neuweiler/ApiSauna/docs/schematics.pdf

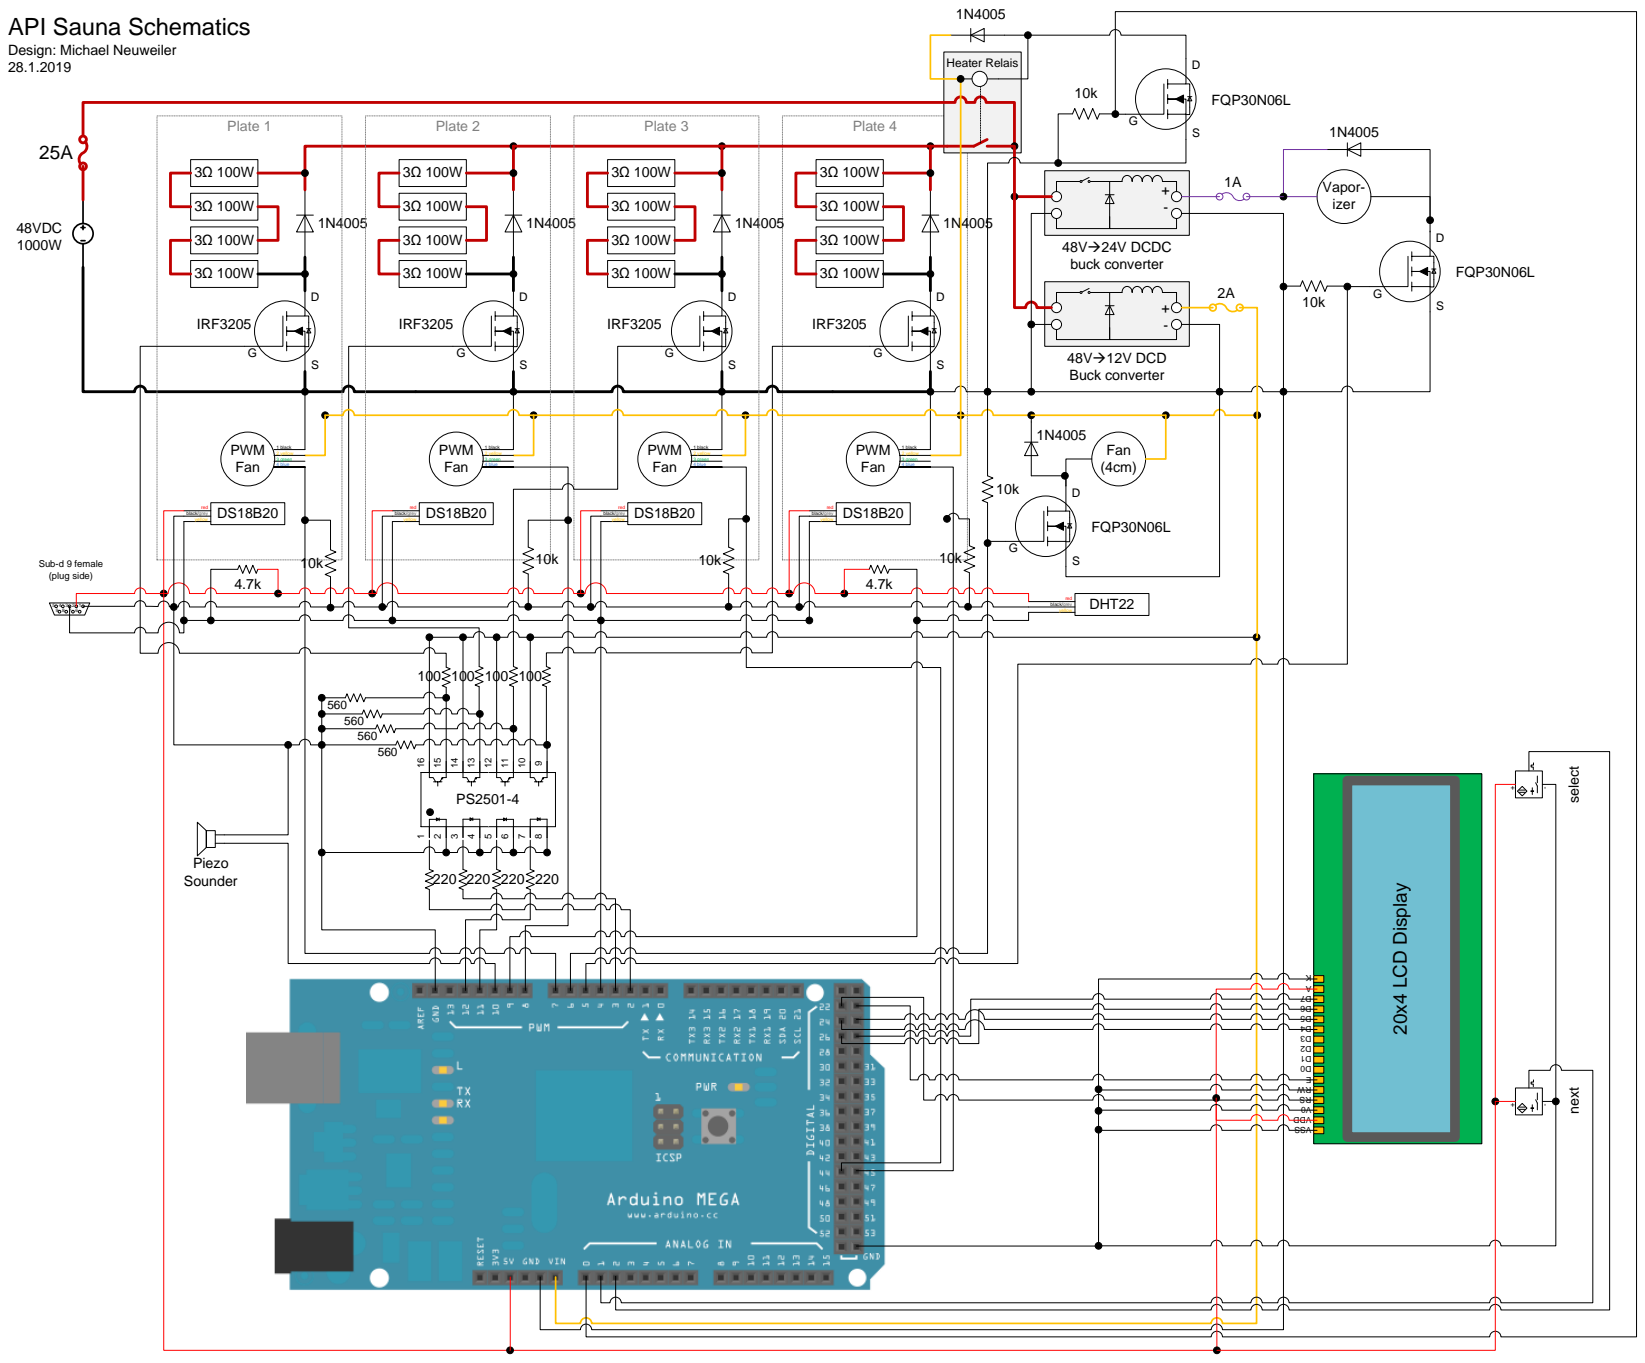
[picture p1: page 1]
Plate 4; Heater Relais; IRF3205; 1N4005 48VDC 1000W; 48Và24V DCDC buck converter; FQP30N06L D G; Plate 1; PWM Fan; 1 black 2 yellow 3 green 4 blue red black/grey yellow; Plate 2; Plate 3; Fan (4cm); Vapor- izer; DHT22 red black/grey yellow 4.7k; Piezo Sounder; - next select; 10k Sub-d 9 female (plug side) 5 4 3 2 1 9 8 7 6

API Sauna Schematics Design: Michael Neuweiler 28.1.2019

48Và12V DCD Buck converter

Display SSV DDV
