neuweiler/ApiSauna/ApiSauna.ino

/*
 * ApiSauna.ino
 *
 * The main application, hands over control to the Controller class.
 *
 Copyright (c) 2017 Michael Neuweiler

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
 */

#include "ApiSauna.h"

/**
 * The initial setup function called after device reset/power-up
 */
void setup()
{
    Serial.begin(CFG_SERIAL_SPEED);
    Serial.println(CFG_VERSION);

    Controller::getInstance()->initialize();
}

/**
 * The main program loop
 */
void loop()
{
    Controller::getInstance()->process();

    delay(CFG_LOOP_DELAY);
}
