neuweiler/ApiSauna/Controller.cpp

/*
 * Controller.cpp
 *
 * The main controller which coordinates and controlls all parts of the
 * bee sauna..
 *
 Copyright (c) 2017 Michael Neuweiler

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
 */

#include "Controller.h"

Controller::Controller()
{
    actualTemperature = -999;
    targetTemperature = 0;
    plateTemperature = 0;
    plateTargetTemperature = 0;

    tickCounter = 0;
    pid = NULL;
}

Controller::~Controller()
{
    if (pid) {
        delete pid;
        pid = NULL;
    }
}

/**
 * Return the instance of the singleton
 */
Controller *Controller::getInstance()
{
    static Controller instance;
    return &instance;
}

/**
 * Initialize the controller and referenced devices.
 */
void Controller::initialize()
{
    Logger::info(F("initializing controller"));

    if (!Configuration::getInstance()->load() || !Statistics::getInstance()->load()) {
        status.setSystemState(Status::error);
        return;
    }
    Logger::setLoglevel((Logger::LogLevel)Configuration::getInstance()->getParams()->loglevel);

    initOutput();
    powerDownDevices();

    ProgramHandler::getInstance()->initPrograms();
    ProgramHandler::getInstance()->attach(this);
    hid.initialize();
    humidifier.initialize();

    SimpleList<SensorAddress> addressList = detectTemperatureSensors();
    if (!assignPlateSensors(addressList) || !assignHiveSensors(addressList)) {
        for (SimpleList<SensorAddress>::iterator itr = addressList.begin(); itr != addressList.end(); ++itr) {
            Logger::info(F("  found sensor: %#08lx%08lx"), itr->high, itr->low);
        }
        status.setSystemState(Status::error);
        return;
    }

    initPid();
    status.setSystemState(Status::ready);
    serialConsole.printMenu();
}

/**
 * Initialize output ports
 */
void Controller::initOutput()
{
    Logger::info(F("initializing output"));

    ConfigurationIO *configIo = Configuration::getIO();
    pinMode(configIo->heaterRelay, OUTPUT);
    for (int i = 0; i < Configuration::getParams()->numberOfPlates; i++) {
        if (configIo->heater[i] != 0)
            pinMode(configIo->heater[i], OUTPUT);
        if (configIo->fan[i] != 0)
            pinMode(configIo->fan[i], OUTPUT);
    }
    pinMode(configIo->vaporizer, OUTPUT);
    pinMode(configIo->humidifierFan, OUTPUT);
}

/**
 * Initialize the PID to define the plateTemperature based on the targetTemperature and the
 * actual temperature of the hive.
 */
void Controller::initPid()
{
    pid = new PID(&actualTemperature, &plateTemperature, &targetTemperature, 0, 0, 0, DIRECT);
    pid->SetOutputLimits(0, Configuration::getParams()->plateOverTemp);
    pid->SetSampleTime(CFG_LOOP_DELAY);
    pid->SetMode(AUTOMATIC);
}

/**
 * Tell all devices to power-down.
 */
void Controller::powerDownDevices()
{
    for (SimpleList<Plate>::iterator itr = plates.begin(); itr != plates.end(); ++itr) {
        itr->setMaximumPower(0);
        itr->setFanSpeed(Configuration::getParams()->minFanSpeed);
        itr->process();
        itr->pause();
    }
    humidifier.setMinHumidity(0);
    humidifier.setMaxHumidity(1);
    humidifier.setFanSpeed(0);
    humidifier.process();

    delay(500);
    digitalWrite(Configuration::getIO()->heaterRelay, LOW);
}

/**
 *  Find all temperature sensor addresses (DS18B20).
 */
SimpleList<SensorAddress> Controller::detectTemperatureSensors()
{
    SimpleList<SensorAddress> addressList;
    Logger::info(F("detecting temperature sensors"));
    TemperatureSensor::resetSearch();

    while (true) {
        SensorAddress address = TemperatureSensor::search();
        if (address.value == 0)
            break;
        Logger::info(F("  found sensor: %#08lx%08lx"), address.high, address.low);
        addressList.push_back(address);
    }
    TemperatureSensor::prepareData(); // kick the sensors to prepare data
    return addressList;
}

bool Controller::containsSensorAddress(SimpleList<SensorAddress> &addressList, SensorAddress address)
{
    for (SimpleList<SensorAddress>::iterator itrAddress = addressList.begin(); itrAddress != addressList.end(); ++itrAddress) {
        if (itrAddress->value == address.value)
            return true;
    }
    return false;
}

/**
 * Assign all found temperature sensors either to heating plates or use them to measure the
 * hive's temperature.
 */
bool Controller::assignPlateSensors(SimpleList<SensorAddress> &addressList)
{
    ConfigurationIO *configIO = Configuration::getIO();
    ConfigurationSensor *configSensor = Configuration::getSensor();

    plates.reserve(Configuration::getParams()->numberOfPlates);
    for (int i = 0; i < Configuration::getParams()->numberOfPlates; i++) {
        if (configSensor->addressPlate[i].value != 0 && containsSensorAddress(addressList, configSensor->addressPlate[i]) && configIO->fan[i] != 0
                && configIO->heater[i] != 0) {
            Logger::info(F("attaching sensor %#08lx%08lx, heater pin %d, fan pin %d to plate #%d"), configSensor->addressPlate[i].high,
                    configSensor->addressPlate[i].low, configIO->heater[i], configIO->fan[i], i + 1);
            Plate plate = Plate();
            plates.push_back(plate);
        }
    }

    // initialize plates after adding them to list because adding deletes/re-creates the plate objects and would mess with its allocated objects otherwise
    int i = 0;
    for (SimpleList<Plate>::iterator itr = plates.begin(); itr != plates.end(); ++itr) {
        itr->initialize(i++);
    }

    if (Configuration::getParams()->numberOfPlates != plates.size()) {
        Logger::error(F("unable to locate all configured plate sensors (%d of %d) !!"), plates.size(), Configuration::getParams()->numberOfPlates);
        status.errorCode = Status::plateSensorsNotFound;
        return false;
    }
    return true;
}

/**
 * Verify that all configured hive temperature sensors are found in the search for sensors.
 */
bool Controller::assignHiveSensors(SimpleList<SensorAddress> &addressList)
{
    ConfigurationSensor *configSensor = Configuration::getSensor();

    for (int i = 0; configSensor->addressHive[i].value != 0 && i < CFG_MAX_NUMBER_PLATES; i++) {
        if (containsSensorAddress(addressList, configSensor->addressHive[i])) {
            Logger::info(F("attaching sensor %#08lx%08lx as hive sensor #%d"), configSensor->addressHive[i].high, configSensor->addressHive[i].low,
                    i + 1);
            TemperatureSensor sensor = TemperatureSensor(i, false);
            hiveTempSensors.push_back(sensor);
        } else {
            Logger::error(F("unable to locate all configured hive sensors (%#l08x%08lx missing) !!"), configSensor->addressHive[i].high,
                    configSensor->addressHive[i].low);
            status.errorCode = Status::hiveSensorsNotFound;
            return false;
        }
    }
    return true;
}

/**
 * Retrieve temperature data from all sensors and return second highest value (in 0.1 deg C)
 *
 * We assume that either 1 ore 3+ sensors are being used and use a bit a more aggressive
 * approach to heat the hive - if one temp sensor is placed badly or being heated by the bees,
 * it would take too long to heat up the entire hive.
 */
int16_t Controller::retrieveHiveTemperatures()
{
    int16_t max = -999, secondMax = -999;

    int i = 0;
    for (SimpleList<TemperatureSensor>::iterator itr = hiveTempSensors.begin(); itr != hiveTempSensors.end(); ++itr) {
        itr->retrieveData();
        if (i < CFG_MAX_NUMBER_PLATES)
            status.temperatureHive[i++] = itr->getTemperatureCelsius();
        max = max(max, itr->getTemperatureCelsius());
    }

    for (i = 0; i < CFG_MAX_NUMBER_PLATES; i++) {
        if (status.temperatureHive[i] != max) {
            secondMax = max(secondMax, status.temperatureHive[i]);
        }
    }
    if (secondMax == -999) {
        secondMax = max;
    }
    status.temperatureActualHive = secondMax;
    return secondMax;
}

/**
 * Calculate the desired plate temperature based on the hive temperature and the current state. (in 0.1 deg C)
 */
int16_t Controller::calculatePlateTargetTemperature()
{
    Program *runningProgram = ProgramHandler::getInstance()->getRunningProgram();
    if (actualTemperature == -999 || runningProgram == NULL) {
        return 0;
    }

    if (status.getSystemState() == Status::preHeat) {
        targetTemperature = runningProgram->temperaturePreHeat;
    } else {
        targetTemperature = runningProgram->temperatureHive;
    }

    pid->Compute();

    // don't set directly as plateTemperature tends to jump. Dampen with 0.1 deg per second
    if (plateTemperature > plateTargetTemperature)
        plateTargetTemperature++;
    else if (plateTemperature < plateTargetTemperature)
        plateTargetTemperature--;

    plateTargetTemperature = constrain(plateTargetTemperature, 0, runningProgram->temperaturePlate);
    status.temperatureTargetHive = targetTemperature;
    status.temperatureTargetPlate = plateTargetTemperature;

    return plateTargetTemperature;
}

/**
 * Check if a state has reached its execution time or a problem has occured
 */
void Controller::updateProgramState()
{
    ProgramHandler *programHandler = ProgramHandler::getInstance();
    Program *runningProgram = programHandler->getRunningProgram();
    uint32_t timeRemaining = programHandler->calculateTimeRemaining();

    if (actualTemperature > Configuration::getParams()->hiveOverTemp) {
        Logger::error(F("ALERT - OVER-TEMPERATURE IN HIVE ! Trying to recover, please open the cover to help cool down the hive!"));
        status.setSystemState(Status::overtemp);
        status.errorCode = Status::overtempHive;
    }
    if (status.getSystemState() == Status::overtemp && actualTemperature < Configuration::getParams()->hiveOverTempRecover) {
        Logger::info(F("recovered from over-temperature, shutting down."));
        programHandler->stop();
    }

    if (status.getSystemState() == Status::running && timeRemaining < 2) {
        Logger::info(F("program finished."));
        programHandler->stop();
    }

    if (status.getSystemState() == Status::preHeat && runningProgram
            && (timeRemaining == 0 || (actualTemperature >= runningProgram->temperaturePreHeat &&
                    timeRemaining < programHandler->calculateTimeRunning()))) {
        programHandler->switchToRunning();
    }
}

void Controller::handleEvent(ProgramEvent event, Program *program)
{
    Logger::debug(F("controller: incoming event %d, program: %s"), event, (program ? program->name : "n/a"));

    switch (event) {
    case startProgram:
    case updateProgram:
        handleProgramChange(program);
        break;
    case stopProgram:
        powerDownDevices();
        break;
    case pauseProgram:
        for (SimpleList<Plate>::iterator itr = plates.begin(); itr != plates.end(); ++itr) {
            itr->pause();
        }
        break;
    case resumeProgram:
        for (SimpleList<Plate>::iterator itr = plates.begin(); itr != plates.end(); ++itr) {
            itr->resume();
        }
        break;
    }
}

/**
 * This is the main control loop.
 */
void Controller::process()
{
    hid.process();
    serialConsole.process();

    if (tickCounter++ > 9) {
        tickCounter = 0;
        humidifier.process();
        actualTemperature = retrieveHiveTemperatures();
        updateProgramState();

        switch (status.getSystemState()) {
        case Status::init:
            break;
        case Status::ready:
            break;
        case Status::preHeat:
        case Status::running: {
            int16_t plateTemp = calculatePlateTargetTemperature();
int i = 0;
            for (SimpleList<Plate>::iterator itr = plates.begin(); itr != plates.end(); ++itr) {
if (i == 2 || i == 3) {
	if (status.temperatureHive[2] <390 && status.temperatureHive[3] < 390)
		plateTemp = 750;
	else if (status.temperatureHive[2] <400 && status.temperatureHive[3] < 400)
		plateTemp = 700;
	else if (status.temperatureHive[2] <410 && status.temperatureHive[3] < 410)
		plateTemp = 650;
}
i++;
                itr->setTargetTemperature(plateTemp);
                itr->process();
            }
            Program *runningProgram = ProgramHandler::getInstance()->getRunningProgram();
            if (runningProgram->changed) {
                handleProgramChange(runningProgram);
                runningProgram->changed = false;
            }
            break;
        }
        case Status::overtemp: // shut-down heaters, plate fan to minimum, full blow humidifier fan (fresh air) !!
            for (SimpleList<Plate>::iterator itr = plates.begin(); itr != plates.end(); ++itr) {
                itr->setMaximumPower(0);
                itr->setFanSpeed(Configuration::getParams()->minFanSpeed);
                itr->process();
            }
            humidifier.setMinHumidity(99);
            humidifier.setMaxHumidity(100);
            humidifier.setFanSpeed(255);
            humidifier.process();
            delay(200); // wait a bit before trying to open the relay
            digitalWrite(Configuration::getIO()->heaterRelay, LOW);
            break;
        case Status::shutdown:
            break;
        case Status::error:
            powerDownDevices();
            break;
        }
        TemperatureSensor::prepareData();
    }
}

void Controller::handleProgramChange(Program *program)
{
    Status::SystemState state = status.getSystemState();
    bool preHeat = (state == Status::preHeat);
    bool running = (state == Status::running);

    Logger::info(F("Updating devices with new program settings"));

    // adjust the PID which defines the target temperature of the plates based on the hive temp
    pid->SetOutputLimits((preHeat ? program->temperaturePreHeat : program->temperatureHive), program->temperaturePlate);
    pid->SetTunings(program->hiveKp, program->hiveKi, program->hiveKd);
    plateTargetTemperature = program->temperaturePlate;

    // adjust the parameters of the plates
    for (SimpleList<Plate>::iterator itr = plates.begin(); itr != plates.end(); ++itr) {
        itr->setPIDTuning(program->plateKp, program->plateKi, program->plateKd);
        itr->setMaximumPower(Configuration::getParams()->maxHeaterPower);
        itr->setFanSpeed(preHeat ? program->fanSpeedPreHeat : program->fanSpeed);
    }

    // adjust the parameters of the humidifier
    humidifier.setFanSpeed(program->fanSpeedHumidifier);
    humidifier.setMinHumidity(program->humidityMinimum);
    humidifier.setMaxHumidity(program->humidityMaximum);

    digitalWrite(Configuration::getIO()->heaterRelay, (running || preHeat ? HIGH : LOW));
    delay(200); // allow the relay to open/close
}

int16_t Controller::getHiveTargetTemperature()
{
    return targetTemperature;
}
