neuweiler/ApiSauna/Configuration.cpp

/*
 * Configuration.cpp
 *
 Copyright (c) 2017 Michael Neuweiler

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
 */

#include "Configuration.h"

Configuration::Configuration()
{
}

Configuration::~Configuration()
{
}

/**
 * Return the instance of the singleton
 */
Configuration *Configuration::getInstance()
{
    static Configuration instance;
    return &instance;
}

/**
 * Load the configuration from EEPROM and verify the CRC values
 * as well as the existance of the ApiSauna token.
 *
 * If the token is not found, it is assumed that the configuration was never saved on this board and the config is re-set and saved.
 * If a CRC check fails, a error is printed to the log and HID and false is returned - causing the controller to go into error state.
 */
bool Configuration::load()
{
    Logger::info(F("loading configuration"));
    EEPROM.get(CONFIG_ADDRESS_IO, *getIO());
    EEPROM.get(CONFIG_ADDRESS_PARAMS, *getParams());
    EEPROM.get(CONFIG_ADDRESS_SENSOR, *getSensor());

    if (getParams()->token != CFG_EEPROM_CONFIG_TOKEN) {
        Logger::warn(F("no ApiSauna token found in EEPROM --> resetting configuration and statistics"));
        reset();
        save();
        Statistics::getInstance()->reset();
        Statistics::getInstance()->save();
    }

    if (getParams()->crc != Crc::calculate((uint8_t *) getParams() + 4, sizeof(ConfigurationParams) - 4)) {
        Logger::error(F("invalid crc detected in parameter configuration"));
        status.errorCode = Status::crcParam;
        return false;
    }
    if (getIO()->crc != Crc::calculate((uint8_t *) getIO() + 4, sizeof(ConfigurationIO) - 4)) {
        Logger::error(F("invalid crc detected in I/O configuration"));
        status.errorCode = Status::crcIo;
        return false;
    }
    if (getSensor()->crc != Crc::calculate((uint8_t *) getSensor() + 4, sizeof(ConfigurationSensor) - 4)) {
        Logger::error(F("invalid crc detected in sensor configuration"));
        status.errorCode = Status::crcSensor;
        return false;
    }

    if (getParams()->numberOfPlates > CFG_MAX_NUMBER_PLATES) {
        getParams()->numberOfPlates = CFG_MAX_NUMBER_PLATES;
    }

    return true;
}

/**
 * Calculate and set the CRC values of all configurations.
 */
void Configuration::updateCrc()
{
    getParams()->crc = Crc::calculate((uint8_t*) (getParams()) + 4, sizeof(ConfigurationParams) - 4);
    getIO()->crc = Crc::calculate((uint8_t*) (getIO()) + 4, sizeof(ConfigurationIO) - 4);
    getSensor()->crc = Crc::calculate((uint8_t*) (getSensor()) + 4, sizeof(ConfigurationSensor) - 4);
}

/**
 * Re-calc the CRC values and store all configuration blocks to EEPROM.
 */
void Configuration::save()
{
    Logger::info(F("saving configuration to EEPROM"));

    updateCrc();
    EEPROM.put(CONFIG_ADDRESS_IO, *getIO());
    EEPROM.put(CONFIG_ADDRESS_PARAMS, *getParams());
    EEPROM.put(CONFIG_ADDRESS_SENSOR, *getSensor());

    Logger::info(F("done"));
}

/**
 * Reset the configuration to default values and update the CRCs.
 */
void Configuration::reset()
{
    Logger::info(F("resetting configuration to default values"));

    ConfigurationIO *configIO = getIO();
    ConfigurationParams *configParams = getParams();
    ConfigurationSensor *configSensor = getSensor();

    configParams->token = CFG_EEPROM_CONFIG_TOKEN;
    configParams->version = 1;

    for (int i = 0; i < CFG_MAX_NUMBER_PLATES; i++) {
        configIO->heater[i] = 0;
        configIO->fan[i] = 0;
        configSensor->addressPlate[i].value = 0;
        configSensor->addressHive[i].value = 0;
    }

    configIO->heartbeat = 13; //13 is L, 73 is TX, 72 is RX
    configIO->temperatureSensor = 4;
    configIO->humiditySensor = 9;
    configIO->humiditySensorType = 22;
    configIO->vaporizer = 5;
    configIO->humidifierFan = 6;
    configIO->heaterRelay = A0;
    configIO->heater[0] = 2;
    configIO->heater[1] = 3;
    configIO->heater[2] = 11;
    configIO->heater[3] = 12;
    configIO->fan[0] = 7;
    configIO->fan[1] = 8;
    configIO->fan[2] = 44;
    configIO->fan[3] = 45;
    configIO->buttonNext = A1;
    configIO->buttonSelect = A2;
    configIO->beeper = 10;
    configIO->lcdRs = 22;
    configIO->lcdEnable = 23;
    configIO->lcdD4 = 24;
    configIO->lcdD5 = 25;
    configIO->lcdD6 = 26;
    configIO->lcdD7 = 27;

    configParams->numberOfPlates = 4;
    configParams->maxHeaterPower = 170;
    configParams->minFanSpeed = 10;
    configParams->hiveOverTemp = 460;
    configParams->hiveOverTempRecover = 350;
    configParams->plateOverTemp = 850;
    configParams->usePWM = 0;
    configParams->maxConcurrentHeaters = 2;
    configParams->humidifierFanDryTime = 2;
    configParams->loglevel = Logger::Info;

    configSensor->addressPlate[0].value = 0x0;
    configSensor->addressPlate[1].value = 0x0;
    configSensor->addressPlate[2].value = 0x0;
    configSensor->addressPlate[3].value = 0x0;
    configSensor->addressHive[0].value = 0x0;
    configSensor->addressHive[1].value = 0x0;
    configSensor->addressHive[2].value = 0x0;
    configSensor->addressHive[3].value = 0x0;

    updateCrc();
}

/*
 * Returns the singleton instance of the I/O configuration.
 */
ConfigurationIO *Configuration::getIO()
{
    static ConfigurationIO configIO;
    return &configIO;
}

/*
 * Returns the singleton instance of the parameter configuration.
 */
ConfigurationParams *Configuration::getParams()
{
    static ConfigurationParams configParams;
    return &configParams;
}

/*
 * Returns the singleton instance of the sensor configuration.
 */
ConfigurationSensor *Configuration::getSensor()
{
    static ConfigurationSensor configSensor;
    return &configSensor;
}
