neuweiler/ApiSauna/Plate.cpp

/*
 * Plate.cpp
 *
 * Class which controls a single heating palte which consists of a heating element,
 * temperature sensor (to measure the plate's heat) and a fan to distribute the heat.
 *
 Copyright (c) 2017 Michael Neuweiler

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
 */

#include "Plate.h"

uint8_t Plate::activeHeaters = 0;

Plate::Plate() :
        Device()
{
    currentTemperature = 0.0;
    targetTemperature = 0.0;
    power = 0.0;
    maxPower = 0;
    index = 0;
    pid = NULL;
    sensorHeater = NULL;
    heater = NULL;
    fan = NULL;
    paused = false;
    on = false;
}

void Plate::initialize()
{
    Device::initialize();

    maxPower = Configuration::getParams()->maxHeaterPower;

    pid = new PID(&currentTemperature, &power, &targetTemperature, 0, 0, 0, DIRECT);
    pid->SetOutputLimits(0, maxPower);
    pid->SetSampleTime(CFG_LOOP_DELAY);
    pid->SetMode(AUTOMATIC);
}

void Plate::initialize(uint8_t index)
{
    Logger::debug(F("initializing plate %d"), index + 1);

    initialize();
    this->index = index;
    sensorHeater = new TemperatureSensor(index, true);
    heater = new Heater(index);
    fan = new Fan(Configuration::getIO()->fan[index]);
    fan->setSpeed(Configuration::getParams()->minFanSpeed);
}

Plate::~Plate()
{
}

/**
 * Set the desired temperature of the plate (in 0.1 deg C)
 */
void Plate::setTargetTemperature(int16_t temperature)
{
    targetTemperature = temperature;
}

int16_t Plate::getTargetTemperature()
{
    return targetTemperature;
}

/**
 * Set the maximum temperature of the plate (0-255)
 */
void Plate::setMaximumPower(uint8_t power)
{
    this->maxPower = constrain(power, (double ) 0, Configuration::getParams()->maxHeaterPower);
    pid->SetOutputLimits(0, this->maxPower);
}

uint8_t Plate::getMaximumPower()
{
    return maxPower;
}

/**
 * Set the plate's fan speed (0-255)
 */
void Plate::setFanSpeed(uint8_t speed)
{
    fan->setSpeed(speed);
    status.fanSpeedPlate[index] = speed;
}

/**
 * Set the tuning parameters of the PID controller for the plate temperature
 */
void Plate::setPIDTuning(double kp, double ki, double kd)
{
    pid->SetTunings(kp, ki, kd);
}

/**
 * Get the temperature of the plate in 0.1 deg C
 */
int16_t Plate::getTemperature()
{
    return sensorHeater->getTemperatureCelsius();
}

/**
 * Get the applied power of the heater (0-255)
 */
uint8_t Plate::getPower()
{
    return heater->getPower();
}

/**
 * Get the current fan speed.
 */
uint8_t Plate::getFanSpeed()
{
    return fan->getSpeed();
}

/**
 * Get the plate's index.
 */
uint8_t Plate::getIndex()
{
    return index;
}

/**
 * Interrupt the heating
 */
void Plate::pause()
{
    paused = true;
    heater->setPower(0);
}

/**
 * Resume normal operation
 */
void Plate::resume()
{
    paused = false;
}

/**
 * Update the plat's PID data and derive the power level to command (0-255 for PWM, 0 / 255 for non-PWM).
 * In non-PWM mode, the number of concurrently active plates is also limited to the configured amount.
 *
 */
uint8_t Plate::calculateHeaterPower()
{
    ConfigurationParams *params = Configuration::getParams();

    pid->Compute(); // updates power
    if (Logger::isDebug()) {
        Logger::debug(F("Calculated power for plate %d: %d"), index, power);
    }

    if (currentTemperature > params->plateOverTemp) {
        Logger::error(F("ALERT !!! Plate %d is over-heating !!!"), index + 1);
        status.setSystemState(Status::overtemp);
        status.errorCode = Status::overtempPlate;
        power = 0;
    }

    if (params->usePWM) {
        return constrain(power, (double )0, maxPower);
    } else {
        if ((power > params->maxHeaterPower / 2) && (activeHeaters < params->maxConcurrentHeaters)) {
            if (!on) {
                on = true;
                activeHeaters++;
            }
            return 255;
        } else {
            if (on) {
                on = false;
                activeHeaters--;
            }
            return 0;
        }
    }
}

/**
 * Method called for each plate in the main loop.
 * It re-calculates the power and fan speed according to current
 * settings and sensor data.
 */
void Plate::process()
{
    Device::process();
    sensorHeater->retrieveData();
    currentTemperature = sensorHeater->getTemperatureCelsius();
    status.temperaturePlate[index] = currentTemperature;

    uint8_t power = (paused ? 0 : calculateHeaterPower());
    status.powerPlate[index] = power;
    heater->setPower(power);
}
