neuweiler/ApiSauna/Status.h

/*
 * Status.h
 *
 Copyright (c) 2017 Michael Neuweiler

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
 */

#ifndef STATUS_H_
#define STATUS_H_

#include "config.h"
#include "Logger.h"
#include "Configuration.h"

class Status
{
public:
    enum SystemState
    {
        init = 1, // the system is being initialized and is not ready for operation yet (next states: ready, error)
        ready = 2, // the system is ready to accept commands but the treatment has not started yet (next states: preHeat, running, error)
        preHeat = 3, // a program was started and the system is heating up the hive (next states: running, error)
        running = 4, // the system is running a program (next states: ready, shutdown, error)
        overtemp = 5, // the hive's temperature is/was too high (next states: shutdown, error)
        shutdown = 9, // the system is shut-down
        error = 99 // the system is in an error state and not operational
    };

    enum ErrorCode
    {
        none = 0, // no error, all green
        crcParam = 1, // crc of parameter config invalid
        crcIo = 2, // crc of I/O config invalid
        crcSensor = 3, // crc of sensor config invalid
        crcStatistics = 4, // crc of statistics invalid
        plateSensorsNotFound = 5, // could not locate all configured plate temperature sensors
        hiveSensorsNotFound = 6, // could not locate all configured hive temperature sensors
        overtempHive = 7, // the temperature of the hive is too high
        overtempPlate = 8, // the temperature of a plate is too high
        invalidState = 9
    };

    Status();
    SystemState getSystemState();
    SystemState setSystemState(SystemState);
    String systemStateToStr(SystemState);
    String getError();

    ErrorCode errorCode;
    int16_t temperatureHive[CFG_MAX_NUMBER_PLATES];
    int16_t temperaturePlate[CFG_MAX_NUMBER_PLATES];
    int16_t temperatureActualHive;
    int16_t temperatureTargetHive;
    int16_t temperatureTargetPlate;
    int16_t temperatureHumidifier;
    uint8_t powerPlate[CFG_MAX_NUMBER_PLATES];
    uint8_t fanSpeedPlate[CFG_MAX_NUMBER_PLATES];
    uint8_t fanSpeedHumidifier;
    uint32_t fanTimeHumidifier;
    bool vaporizerEnabled;
    uint8_t humidity;

private:
    SystemState systemState; // the current state of the system, to be modified by the state machine of this class only
};

extern Status status;

#endif /* STATUS_H_ */
