neuweiler/ApiSauna/ProgramHandler.h

/*
 * Program.h
 *
 Copyright (c) 2018 Michael Neuweiler

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
 */

#ifndef PROGRAMHANDLER_H_
#define PROGRAMHANDLER_H_

#include <Arduino.h>
#include "Logger.h"
#include "SimpleList.h"
#include "Status.h"

class Program
{
public:
    char name[17]; // name to be displayed in menu
    int16_t temperaturePreHeat; // the target hive temperature during pre-heat (in 0.1 deg C)
    int16_t temperatureHive; // the target hive temperature (in 0.1 deg C)
    double hiveKp, hiveKi, hiveKd; // hive temperature PID configuration
    int16_t temperaturePlate; // the target temperature of the heater plates (in 0.1 deg C)
    double plateKp, plateKi, plateKd; // plate temperature PID configuration
    uint8_t fanSpeedPreHeat; // the fan speed during pre-heat (0-255)
    uint8_t fanSpeed; // the fan speed (0-255)
    uint16_t durationPreHeat; // the duration of the pre-heating cycle (in min)
    uint16_t duration; // the duration of the program (in min)
    uint8_t fanSpeedHumidifier; // the fan speed of the humidifier fan (when active (0-255)
    uint8_t humidityMinimum; // the minimum relative humidity in %
    uint8_t humidityMaximum; // the maximum relative humidity in %
//TODO send an event instead of using the changed flag
    bool changed; // the program's values were changed indicating a required update
};

enum ProgramEvent
{
    startProgram,
    stopProgram,
    pauseProgram,
    resumeProgram,
    updateProgram
};

class ProgramObserver
{
public:
    virtual void handleEvent(ProgramEvent event, Program *program);
};

class ProgramHandler
{
public:
    static ProgramHandler *getInstance();
    virtual ~ProgramHandler();
    void initPrograms();
    SimpleList<Program> *getPrograms();
    void start(uint8_t programNumber);
    void stop();
    void pause();
    void resume();
    void addTime(uint16_t seconds);
    Program *getRunningProgram();
    uint32_t calculateTimeRunning();
    uint32_t calculateTimeRemaining();
    void attach(ProgramObserver *observer);
    void switchToRunning();

private:
    ProgramHandler();
    ProgramHandler(ProgramHandler const&); // copy disabled
    void operator=(ProgramHandler const&); // assigment disabled    SimpleList<Program> programs;
    void sendEvent(ProgramEvent event, Program *program);

    Program *runningProgram;
    SimpleList<Program> programs;
    SimpleList<ProgramObserver *> observers;
    uint32_t startTime; // timestamp when the program started (in millis)

};

#endif /* PROGRAMHANDLER_H_ */
