neuweiler/ApiSauna/Status.cpp

/*
 * Status.cpp
 *
 * Holds the state machine's current status and transition logic as well as
 * some global status values.
 *
 Copyright (c) 2017 Michael Neuweiler

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
 */

#include "Status.h"

/*
 * Constructor
 */
Status::Status()
{
    systemState = init;
    errorCode = none;
    for (int i = 0; i < CFG_MAX_NUMBER_PLATES; i++) {
        temperatureHive[i] = 0;
        temperaturePlate[i] = 0;
        powerPlate[i] = 0;
        fanSpeedPlate[i] = 0;
    }
    temperatureActualHive = 0;
    temperatureTargetHive = 0;
    temperatureTargetPlate = 0;
    temperatureHumidifier = 0;
    fanSpeedHumidifier = 0;
    fanTimeHumidifier = 0;
    vaporizerEnabled = false;
    humidity = 0;

}

/*
 * Returns the current system state.
 */
Status::SystemState Status::getSystemState()
{
    return systemState;
}

/*
 * Set a new system state. The new system state is validated if the
 * transition is allowed from the old state. If an invalid transition is
 * attempted, the new state will be 'error'.
 * The old and new state are broadcast to all devices.
 */
Status::SystemState Status::setSystemState(SystemState newSystemState)
{
    if (systemState == newSystemState) {
        return systemState;
    }

    if (newSystemState == error || newSystemState == overtemp) { // go in these states unconditionally!
        systemState = newSystemState;
    } else {
        switch (systemState) {
        case init:
            if (newSystemState == ready) {
                systemState = newSystemState;
            }
            break;
        case ready:
            if (newSystemState == preHeat || newSystemState == running || newSystemState == shutdown) {
                systemState = newSystemState;
            }
            break;
        case shutdown:
            if (newSystemState == ready) {
                systemState = newSystemState;
            }
            break;
        case preHeat:
            if (newSystemState == running || newSystemState == shutdown) {
                systemState = newSystemState;
            }
            break;
        case running:
            if (newSystemState == ready || newSystemState == shutdown) {
                systemState = newSystemState;
            }
            break;
        case overtemp:
            if (newSystemState == shutdown) {
                systemState = newSystemState;
            }
            break;
        }
    }
    if (systemState == newSystemState) {
        Logger::info(F("switching to state '%s'"), systemStateToStr(systemState).c_str());
    } else {
        Logger::error(F("switching from state '%s' to '%s' is not allowed"), systemStateToStr(systemState).c_str(), systemStateToStr(newSystemState).c_str());
        systemState = error;
        errorCode = invalidState;
    }

    return systemState;
}

/*
 * Convert the state into a string.
 */
String Status::systemStateToStr(SystemState state)
{
    switch (state) {
    case init:
        return F("initializing");
    case ready:
        return F("ready");
    case preHeat:
        return F("pre-heating");
    case running:
        return F("running");
    case overtemp:
        return F("over-temperature");
    case shutdown:
        return F("shut-down");
    case error:
        return F("error");
    }
    return F("invalid");
}

/*
 * Convert the error code into a string.
 */
String Status::getError()
{
    switch (errorCode) {
    case none:
        return F("no error");
    case crcParam:
        return F("Param config invalid CRC");
    case crcIo:
        return F("I/O config invalid CRC");
    case crcSensor:
        return F("Sensor config invalid CRC");
    case crcStatistics:
        return F("Statistics invalid CRC");
    case plateSensorsNotFound:
        return F("Not all plate sensors found");
    case hiveSensorsNotFound:
        return F("Not all hive sensors found");
    case overtempHive:
        return F("Hive over-temp");
    case overtempPlate:
        return F("Plate over-temp");
    case invalidState:
        return F("Invalid state switch");
    }
    return F("n/a");
}

Status status;
