neuweiler/ApiSauna/(commit log)

2017-08-21 add required libs for humidity sensor
2017-08-22 first working prototype
2017-09-03 add serial console, support for beeper and main heater relay
2017-09-07 add LCD menu and button control, minor improvements
2017-09-07 replace temp-control via derating with PID controller for hive and plates
    [Controller.cpp, Controller.h, Plate.cpp, Plate.h, SerialConsole.cpp, config.h]
2018-01-06 move program definition to controller, adjusting parameters for PID simplify logging
2018-01-06 configure the use of PWM or simple on/off for heaters (via CFG_USE_PWM) to limit the max current use CFG_MAX_CONCURRENT_HEATERS to configure the maximum of heaters active at any moment (in non-PWM mo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
2018-04-29 Major overhaul to allow variable number of plates move config to EEPROM eliminate circular dependencies in code and global variables
    [Configuration.h]
2018-05-24 add humidifier fan dry time (follow-up time after vaporizer stops to reduce the risk of a damaged fan)
    [Configuration.h]
2018-05-24 adjust honey melting params to 30 deg C
    [ProgramHandler.cpp]
2018-05-27 add error codes to be displayed in LCD complete serial console to configure sensor address and arrays refactoring
    [Configuration.h]
2018-05-27 some refactoring and code formatting
    [Configuration.h]
2018-08-09 fix handling of drying time for humidifier fan
    [Humidifier.cpp]
2018-08-13 fix switching off fan with delay after vaporizer
    [Humidifier.cpp]
2018-08-15 reset timer when switching from pre-heat to running adjust program parameters to regulate more precisely and not exceed 41deg C
    [ProgramHandler.cpp, ProgramHandler.h]
2018-08-17 fix rounding of temperatures display temperatures after program is finished / on error allow to start program after shutdown by pressing button
    [HID.cpp, HID.h]
2018-08-17 fix calculation of currently running plates
    [Plate.cpp]
2018-08-17 streamline handling of program changes use second highest temperature to define hive temperature
2018-09-23 simplify menu and reduce to two button operation
    [Configuration.h]
2018-09-25 interact via buttons during program execution: modals, reset
    [HID.cpp, HID.h, ProgramHandler.cpp, ProgramHandler.h, config.h]
2018-09-25 add interaction when program is finished react to state switches process beeper and status led as part of HID
2018-09-26 pause/resume for plate heating
2018-09-26 fix minor glitches in time display
    [HID.cpp, HID.h]
2018-09-26 fix extending running program
    [ProgramHandler.cpp]
2018-09-26 also clean leading digits in case we switch from 2 hour digits to 1
2019-01-30 add LCD display + capacitive buttons/switches replace 4-way optocoupler with newer one
2019-01-30 store loglevel in eeprom adjust pinout to new schematics
    [Configuration.h]
2019-01-30 adjust labeling of LCD pins
    [Configuration.h]
2019-02-19 set cursor correctly also for systems with less than 4 plates
    [HID.cpp]
2019-02-19 fix parsing of unsigned long address
    [SerialConsole.cpp]
2019-02-27 only increase activeHeaters when plate was not already switched on
2019-02-27 add 9-pin sub-d connector for hive temp sensors
2019-02-27 correctly count active heaters
    [Plate.cpp, Plate.h]
2019-05-16 safely shut-down and prevent arcing in heater relay Dampen the target temperature by 0.1deg per second to prevent big jumps
    [Controller.cpp, Controller.h, Plate.cpp]
2019-09-08 migrate to latest arduino plugin version
